ytmytm/C128-keyboard/kicad-c128keyb/DB25-pins.txt

GND	1	GND
NC	2	KEY
NMI	3	RESTORE
VCC	4	VCC

X0	13	PA0	COL
X1	19	PA1
X2	18	PA2
X3	17	PA3
X4	16	PA4
X5	15	PA5
X6	14	PA6
X7	20	PA7
X8	21	K0
X9	22	K1
X10	23	K2

Y0	12	PB0	ROW
Y1	11	PB1
Y2	10	PB2
Y3	5	PB3
Y4	8	PB4
Y5	7	PB5
Y6	6	PB6
Y7	9	PB7

CAPS	25	CAPS
40/80	24	40/80
