ytmytm/C128-keyboard/docs/OPL_Kicad_Library/OPL_List_2019-02-14.xlsx

Sheet: SZOPL
no. | Model | Category | Brand | Desc | Price | Encap
23 | CC0805KRX7R9BB104 | Capacitors | Yageo | 0805 100nF ±10% 50V X7R | 50~0.18|200~0.15|500~0.14|1000~0.13|2000~0.125|4000~0.12 | 805
24 | GRM188R71H104KA93D | Capacitors | Murata | 0603 100nF ±10% 50V X7R | 10~0.1751|200~0.1626|500~0.1563|1000~0.1501|2000~0.1438|4000~0.1376 | 0603（1608 metric）
30 | GCM188R71E105KA64D | Capacitors | Murata | 0603 1μF ±10% 25V X7R | 10~0.3065|100~0.2299|300~0.2158|1000~0.2017|5000~0.1955 | 0603（1608 metric）
31 | CC0603KRX7R7BB104 | Capacitors | Yageo | 0603 100nF ±10% 16V X7R | 50~0.0432|200~0.036|500~0.0336|1000~0.0312|2000~0.03|4000~0.0288 | 603
37 | TAJA226K010RNJ | Capacitors | AVX | A-type 22µF ±10% 10V ESR=3Ω@100kHz | 1~1.0486|10~0.7938|30~0.7448|100~0.7056|500~0.6762 | 1206（3216 metric）
38 | TAJB476K010RNJ | Capacitors | AVX | B-type 47µF ±10% 10V ESR=1Ω@100kHz | 5~0.7229|50~0.5481|150~0.516|500~0.4838|2500~0.4696 | 1411（3528 metric）
39 | TAJE107M025RNJ | Capacitors | AVX | E-type 100µF ±20% 25V ESR=0.3Ω@100kHz | 1~6.5464|10~4.9196|30~4.6256|100~4.3218|500~4.1944 | 2917（7343 metric）
41 | TAJA106K016RNJ | Capacitors | AVX | A-type 10µF ±10% 16V ESR=3Ω@100kHz | 1~0.9898|10~0.7448|30~0.7056|100~0.6566|500~0.637 | 1206（3216 metric）
92 | GRM188R60J106ME47J | Capacitors | Murata | 0603 10μF ±20% 6.3V X5R | 50~0.3684|200~0.2947|500~0.2671|1000~0.2579|2000~0.2487|4000~0.2395 | 0603（1608 metric）
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
3926 | CC0201CRNPO9BN1R2 | Capacitors | Yageo | 0201 1.2pF ±0.25PF 50V C0G | 50~0.0259|200~0.0216|500~0.0201|1000~0.0187|5000~0.018|10000~0.0173 | 201
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
