ytmytm/C128-keyboard/tests/README.md

# Keyboard event regression tests

Run from the repository root:

```sh
python3 tests/test_keyboard_events.py
python3 -m unittest discover -s tests -p 'test_firmware_artifacts.py' -v
```

Requires Python 3 and GCC's g++ with AddressSanitizer and
UndefinedBehaviorSanitizer. Compilation uses `-Wall -Wextra -Werror`;
warnings fail the build. The language standard is C++14, matching the
[Seeed SAMD compiler configuration](https://github.com/Seeed-Studio/ArduinoCore-samd/blob/master/platform.txt).
Compile-time assertions also verify key lookup and modifier table sizes.

The Python runner reads functions directly from the firmware and compiles them
with the C++ scenarios in `keyboard_events.cpp`. It uses the real controller
class declaration, parser constructor and Parse implementation, controller
callbacks, the HID device release path, key maps, matrix event handling, constructor, reset and key-action callbacks.
Hardware I/O, USB transport, OLED drawing and ASCII conversion are mocked.
The status renderer itself is compiled from the sketch.
Temporary build files are removed automatically, including on test failure.

The runner first verifies that the installable library ZIP matches the source
folder and that the sketch rejects missing or outdated event API markers.
After editing the USB library, refresh its ZIP before running tests:

```sh
python3 tools/package_usb_library.py
```

Tests cover:

- Firmware date below startup USB status messages, ordinary one-line messages,
  and skipping the renderer when no OLED is present.

- Public modifier event usages `0xe0..0xe7` versus modifier masks, including
  Right Shift, HID usage `0x20` (3) and HID usage `0x2c` (Space).
- All 262,144 pairs of modifier masks across four keymaps, checking the expected
  matrix state, physical Shift flags and RESTORE pin after each transition.
- Ctrl + either Shift in both press/release orders, simultaneous changes,
  independent Shifts, and typing while Shift remains held.
- Six occupied HID slots, slot reordering, key replacement, repeated reports,
  reserved bytes, unknown usages, every error usage in every key slot, and
  report lengths from zero to seven bytes.
- Differential Shift in symbolic mappings and synthesized Shift for cursor
  and function keys; overlapping differential keys and Shift Lock with physical Shift.
- Both joystick ports, all four single-key keypad diagonals in every keymap,
  equivalence to two cardinal keys, 224 overlapping-direction release cases,
  six keypad slots plus right Ctrl, mode changes, OLED labels, diagonals with
  FIRE and Shift, all cardinal directions, three FIRE inputs, shared
  FIRE releases, route/count lifetime, and entering/leaving modes while held.
- Saved releases after changing a mapping to another key, IGNORE or an action.
- Reset, keymap switching and wrapping, momentary RESTORE, toggled 40/80 and
  CAPS pins (including reset), shared RESTORE sources, valid GPIO pin numbers,
  duplicate presses and unmatched releases.
- RESTORE versus DEL isolation and exact Shift/key write ordering.
- Disconnect with held modifiers, normal keys, FIRE, RESTORE and Shift Lock;
  reconnect with the same keys held; repeated releases and interfaces without
  a parser. The real HIDBoot release callback path is used with mocked USB I/O.

The transition count is a count of exercised cases, not a source coverage
percentage. These tests do not build the full Arduino sketch or verify
transport timing or electrical behavior.

For a hardware check, install the modified bundled
`SEEED/C64_USB_Host_Library_SAMD` library and rebuild the sketch; rebuilding
with an older installed library will not include the parser fix. Check Shift +
left Ctrl (C= in positional mode) in both press/release orders, then right Ctrl
and keypad 5 held together in each joystick mode. Releasing either FIRE input
must leave FIRE active until the other is also released.

The old `C128-keyboard-issue-3-shift.patch` is an alternative workaround and
must not be applied on top of the modifier event fix.

# Firmware build and UF2 artifacts

`test_firmware_artifacts.py` checks the release-date/tag contract and the
application/UF2 validator. It rejects invalid vectors, wrong family IDs,
bootloader addresses, incorrect block numbers, missing or reordered blocks,
corrupt payloads and nonzero padding. It needs only Python 3.

The [firmware workflow](../.github/workflows/firmware.yml) also performs a full
Arduino build, converts the BIN with the pinned official Microsoft converter,
and validates every UF2 payload byte before uploading build or release assets.
This compile/format check complements the mocked event tests and hardware tests.
