ytmytm/C128-keyboard/kicad-c128keyb/plots/kicad-c128keyb.pdf

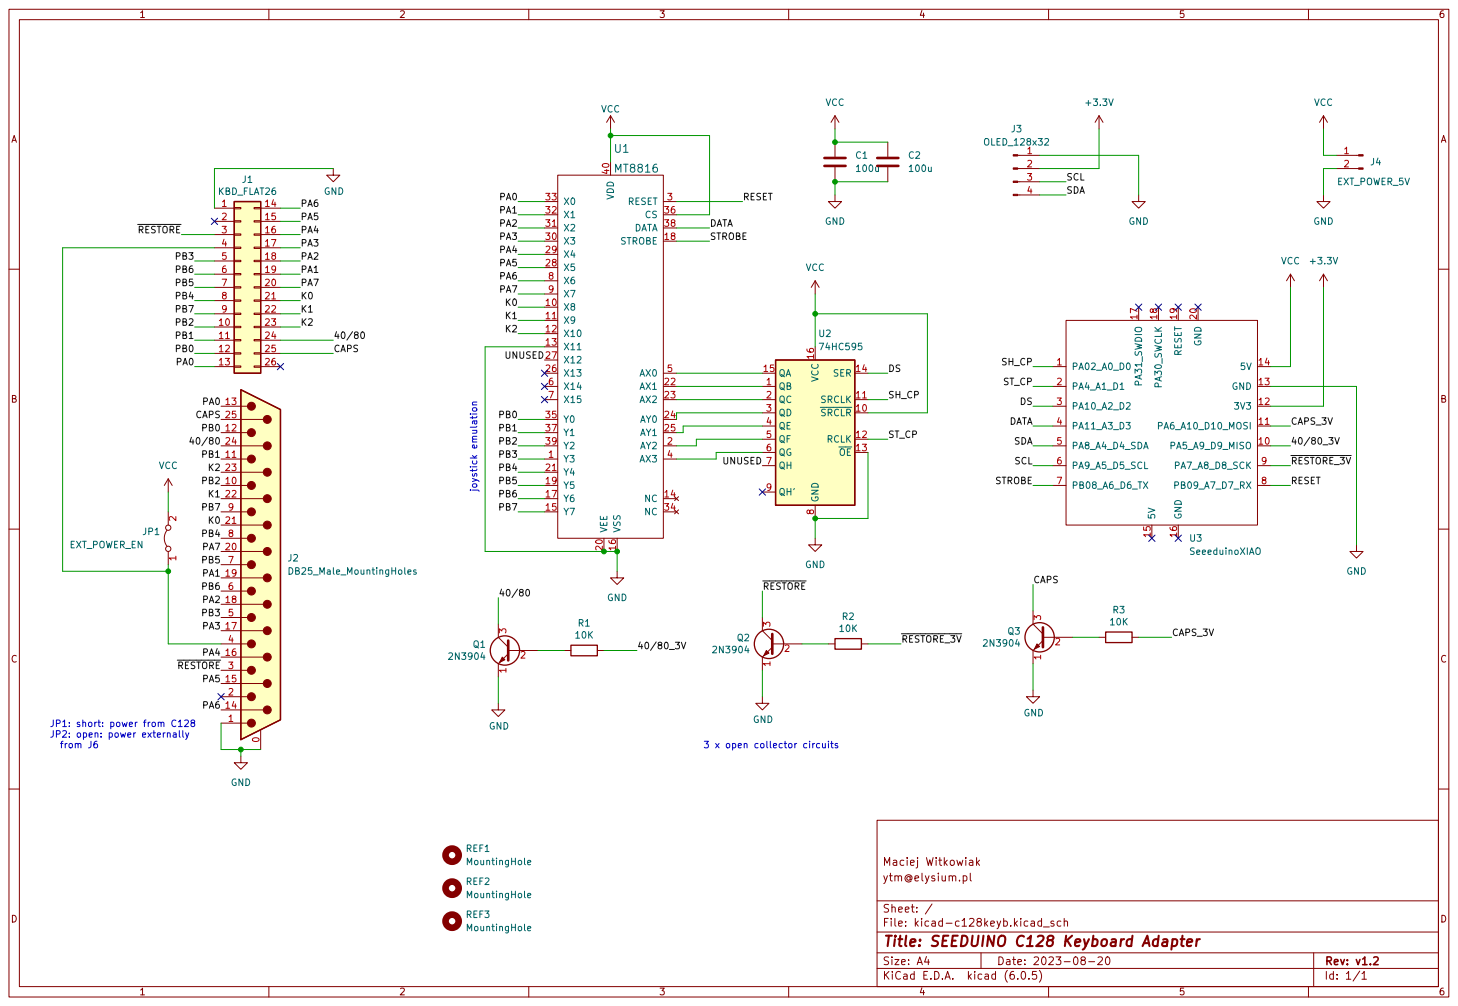
[picture p7: page 1]

Maciej Witkowiak
File: kicad-c128keyb.kicad_sch Sheet: / ytm@elysium.pl

Id: 1/1 Title: SEEDUINO C128 Keyboard Adapter
