ytmytm/C128-keyboard/(list of files, drawings)

Other design files:
kicad-c128keyb/kicad-c128keyb.dsn
