ytmytm/C128-keyboard/SEEED/C64_USB_Host_Library_SAMD/src/KeyboardController.h

/*
 Copyright (c) 2012 Arduino.  All right reserved.

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
 You should have received a copy of the GNU Lesser General Public
 License along with this library; if not, write to the Free Software
 Foundation, Inc., 51 Franklin St, Fifth Floor, Boston, MA  02110-1301  USA
 */

#ifndef KEYBOARD_CONTROLLER_H
#define KEYBOARD_CONTROLLER_H

#include <hidboot.h>

// The sketch depends on separate 0xe0..0xe7 modifier usages and disconnect callbacks.
#define C128_USB_HOST_EVENT_API_VERSION 1

enum KeyboardModifiers {
	LeftCtrl = 1,
	LeftShift = 2,
	Alt = 4,
	LeftCmd = 8,
	RightCtrl = 16,
	RightShift = 32,
	AltGr = 64,
	RightCmd = 128
};

class KeyboardController : public KeyboardReportParser {
public:
  KeyboardController(USBHost &usb) : hostKeyboard(&usb), key(0), keyOem(0), modifiers(0) {
    hostKeyboard.SetReportParser(0, this);
  };

  uint8_t getKey()       { return key; };
  uint8_t getModifiers() { return modifiers; };
  uint8_t getOemKey()    { return keyOem; };

protected:
  void OnDisconnect() override;
  void OnControlKeysChanged(uint8_t before, uint8_t after) override;
  void OnKeyDown(uint8_t mod, uint8_t key) override;
  void OnKeyUp(uint8_t mod, uint8_t key) override;

private:
  HIDBoot<HID_PROTOCOL_KEYBOARD> hostKeyboard;
  uint8_t key, keyOem, modifiers;
};

#endif
