ytmytm/C128-keyboard/SEEED/C128_keyboard/C128keyboard.c.ino

/*
  C128keyboard - Commodore Keyboard library

  Copyright (c) 2022 Hartland PC LLC
  Written by Robert VanHazinga

  Modified for C128 by Maciej 'YTM/Elysium' Witkowiak


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
*/

#include <map>

#include "C128keyboard.h"

// static keymap definitions, include only once
#include "keymaps.h"

#include <ShiftRegister74HC595.h>
ShiftRegister74HC595<1> sr(DS_PIN, SH_CP_PIN, ST_CP_PIN); // data, clock, latch

void resetMT88(void) {

  digitalWrite(NMI_PIN, LOW);
  digitalWrite(C128_40_80_PIN, LOW);
  digitalWrite(C128_CAPS_PIN, LOW);

  digitalWrite(ANALOG_SW_DATA , LOW);
  digitalWrite(ANALOG_SW_RESET, HIGH);
  digitalWrite(ANALOG_SW_STROBE, HIGH);
  delay(20);
  digitalWrite(ANALOG_SW_RESET, LOW);
  digitalWrite(ANALOG_SW_STROBE, LOW);
  digitalWrite(ANALOG_SW_DATA , HIGH);

  lshift = false;
  rshift = false;
  shiftlock = false;
  virtshift = false;

  keymapnum = 0;
  joymode = false;
  joynum = 2;
  joykeycount = 0;
  kpress = false;
  c128_4080 = false;
  c128_caps = false;
}


void setswitch(uint8_t c,bool kstate) {
  int bitr;
  bool state;
  uint8_t ax3;

  ax3 = 0;
  digitalWrite(ANALOG_SW_DATA , kstate);
  // Fix logic table hole in MT8812/16
  // Convert x12 & x13 to x6 & x7. AX3 line control
  if ((c > 55 && c < 64) || (c > 23 && c < 32 )) {
     c -= 24;
     ax3 = 1;
  }
  // C128 extra keys use only 3 rows, so we don't reach x12 & x13 anyway but ax3 must be active for x8/x9/x10
  if (c >= 64) {
    c -= 64;
    ax3 = 1;
  }
  if (c < 64) {
    for (uint8_t i = 0; i<(sizeof(ANALOG_SH_ARRAY)/sizeof(ANALOG_SH_ARRAY[0])); i++) {
      state =  bitRead(c, i);
      sr.setNoUpdate(ANALOG_SH_ARRAY[i], state);
    }
    sr.setNoUpdate(ANALOG_SH_AX3, ax3);
    sr.updateRegisters(); // update the pins to the set values
    digitalWrite( ANALOG_SW_STROBE, HIGH);
    digitalWrite( ANALOG_SW_STROBE, LOW);
  }

  // Reset switch state pin to default high state (Key press).
  //digitalWrite(ANALOG_SW_DATA , HIGH);
}

//////////////////////////////////////////////////////////////

const char* get_mapped_key_name(uint16_t keycode) {
    keycode &= ~MOD_SHIFT;
    for (const auto &info : key_infos) {
        if (info.get_keycode() == keycode) return info.get_name();
    }
    return nullptr;
}

//////////////////////////////////////////////////////////////

// This map will store the original keycode for each pressed key
std::map<uint8_t, uint16_t> keyStateTable;

constexpr uint8_t C128keyboard::getNumKeyMaps(void) { return nkeymaps; };

const char* C128keyboard::getCurrentKeyMapName(void) { return keymaps[keymapnum].getName(); };

uint16_t C128keyboard::mapkeycode(uint8_t kc) {

    if (joymode && (joynum == 1 || joynum == 2)) {
      struct JoystickKey {
        uint8_t usage;
        uint16_t port1;
        uint16_t port2;
      };
      static constexpr std::array<JoystickKey, 11> joystickKeys = {{
        {0x60, JOY1_UP,    JOY2_UP},    // keypad 8
        {0x5a, JOY1_DOWN,  JOY2_DOWN},  // keypad 2
        {0x5c, JOY1_LEFT,  JOY2_LEFT},  // keypad 4
        {0x5e, JOY1_RIGHT, JOY2_RIGHT}, // keypad 6
        {0x59, JOY1_LEFT  | MOD_JOY_DOWN, JOY2_LEFT  | MOD_JOY_DOWN}, // keypad 1
        {0x5b, JOY1_RIGHT | MOD_JOY_DOWN, JOY2_RIGHT | MOD_JOY_DOWN}, // keypad 3
        {0x5f, JOY1_LEFT  | MOD_JOY_UP,   JOY2_LEFT  | MOD_JOY_UP},   // keypad 7
        {0x61, JOY1_RIGHT | MOD_JOY_UP,   JOY2_RIGHT | MOD_JOY_UP},   // keypad 9
        {0x5d, JOY1_FIRE,  JOY2_FIRE},  // keypad 5
        {0x62, JOY1_FIRE,  JOY2_FIRE},  // keypad 0
        {0xe4, JOY1_FIRE,  JOY2_FIRE},  // right Ctrl
      }};
      for (const auto &key : joystickKeys) {
        if (key.usage == kc) {
          return joynum == 1 ? key.port1 : key.port2 | MOD_JOY2;
        }
      }
    }

    // Modifiers arrive as individual HID usages, just like normal keys.
    if (kc >= 0xe0 && kc <= 0xe7) {
      return keymaps[keymapnum].getMods()[kc - 0xe0];
    }

    // scan for any other key
    return keymaps[keymapnum].getKey(kc).get(lshift || rshift || shiftlock || virtshift);
}


// Shift Lock, physical modifiers and differential mappings share the same
// switches. Recompute them from all held keys rather than restoring them on
// the release of just one differential key.
void C128keyboard::updateShiftSwitches(void) {
    bool inverted = false;
    for (const auto &entry : keyStateTable) {
        if (entry.second & MOD_SHIFT) inverted = true;
    }
    const bool left = lshift || shiftlock || virtshift;
    setswitch(KEY_LSHIFT, inverted ? !(left || rshift) : left);
    setswitch(KEY_RSHIFT, inverted ? false : rshift);
}

void C128keyboard::c64key(uint16_t c, bool kpress, uint8_t kc) {

    // Resolve releases before any side effects: the active keymap or
    // joystick mode may have changed since this physical key was pressed.
    if (kpress) {
        if (c == IGNORE_KEYCODE || keyStateTable.count(kc)) return;
        keyStateTable[kc] = c;
    } else {
        auto it = keyStateTable.find(kc);
        if (it == keyStateTable.end()) return;
        c = it->second;
        keyStateTable.erase(it);
    }

    // Both AltGr and PageUp can hold RESTORE. Releasing either source must
    // leave NMI asserted until the final source is released.
    if (c == KEY_RESTORE) {
      bool held = false;
      for (const auto &entry : keyStateTable) {
        if (entry.second == KEY_RESTORE) held = true;
      }
      digitalWrite(NMI_PIN, held);
      return;
    }

    const auto switches = getMatrixSwitches(c);
    if (c == KEY_LSHIFT) lshift = kpress;
    if (c == KEY_RSHIFT) rshift = kpress;

    if (c & MOD_JOY2) {
      if (kpress) { joykeycount++; } else if (joykeycount) { joykeycount--; }
      setswitch(JOY2_ROUTE_GND, joykeycount != 0);
      c -= MOD_JOY2;
    }

    const bool updateShifts = c == KEY_LSHIFT || c == KEY_RSHIFT || (c & MOD_SHIFT);

    // Establish Shift before closing a key; release a key before restoring Shift.
    if (updateShifts && kpress) updateShiftSwitches();

    // Keep every component active while any saved mapping still needs it.
    for (const auto target : switches) {
      if (target >= 128 || target == KEY_LSHIFT || target == KEY_RSHIFT) continue;
      bool held = false;
      for (const auto &entry : keyStateTable) {
        const auto active = getMatrixSwitches(entry.second);
        if (active[0] == target || active[1] == target) held = true;
      }
      setswitch(target, kpress || held);
    }
    if (updateShifts && !kpress) updateShiftSwitches();
}


void C128keyboard::clearAllKeys(void) {
  keyStateTable.clear();
  digitalWrite(NMI_PIN, LOW);
  joykeycount = 0;
  lshift = false;
  rshift = false;
  shiftlock = false;
  virtshift = false;
  // MT88xx RESET substitute, just go through all the switches in the matrix and clear them
  for (uint8_t c=0;c<128;c++) { // we have 7 address bits only (AX0..3, AY0..2)
    setswitch(c,LOW);
  }
}


C128keyboard::C128keyboard() {

  // initialize the pins
  pinMode(ANALOG_SW_STROBE, OUTPUT);  // MT88XX strobe
  pinMode(ANALOG_SW_DATA, OUTPUT);   // MT88XX data
  pinMode(ANALOG_SW_RESET, OUTPUT); // MT88XX reset

  pinMode(NMI_PIN, OUTPUT);
  pinMode(C128_40_80_PIN, OUTPUT);
  pinMode(C128_CAPS_PIN, OUTPUT);

  resetMT88();

}
