ytmytm/C128-keyboard/SEEED/C128_keyboard/keymaps.h

//  C64/C128 key maps: symbolic and positional
//
//  Maciej 'YTM/Elysium' Witkowiak

// mapped key information
constexpr static C64KeyInfo key_infos[] = {
   { KEY_DEL, "INST/DEL" }
  ,{ KEY_F1, "F1" }
  ,{ KEY_HORZ_CSR, "CRSR <->" }
  ,{ KEY_F5, "F5" }
  ,{ KEY_RETURN, "RETURN" }
  ,{ KEY_F3, "F3" }
  ,{ KEY_F7, "F7" }
  ,{ KEY_VERT_CSR, "CRSR ^v" }
  ,{ KEY_9, "9" }
  ,{ KEY_M, "M" }
  ,{ KEY_J, "J" }
  ,{ KEY_O, "O" }
  ,{ KEY_I, "I" }
  ,{ KEY_K, "K" }
  ,{ KEY_ZERO, "0" }
  ,{ KEY_N, "N" }
  ,{ KEY_5, "5" }
  ,{ KEY_C, "C" }
  ,{ KEY_D, "D" }
  ,{ KEY_T, "T" }
  ,{ KEY_R, "R" }
  ,{ KEY_F, "F" }
  ,{ KEY_6, "6" }
  ,{ KEY_X, "X" }
  ,{ KEY_POUND, "POUND" }
  ,{ KEY_RSHIFT, "right SHIFT" }
  ,{ KEY_SEMICOLON, ";" }
  ,{ KEY_ARR_UP, "^" }
  ,{ KEY_STAR, "*" }
  ,{ KEY_EQUALS, "=" }
  ,{ KEY_HOME, "CLR/HOME" }
  ,{ KEY_SLASH, "/" }
  ,{ KEY_3, "3" }
  ,{ KEY_Z, "Z" }
  ,{ KEY_A, "A" }
  ,{ KEY_E, "E" }
  ,{ KEY_W, "W" }
  ,{ KEY_S, "S" }
  ,{ KEY_4, "4" }
  ,{ KEY_LSHIFT, "left SHIFT" }
  ,{ KEY_PLUS, "+" }
  ,{ KEY_DOT, "." }
  ,{ KEY_L, "L" }
  ,{ KEY_AT, "@" }
  ,{ KEY_P, "P" }
  ,{ KEY_COLON, ":" }
  ,{ KEY_MINUS, "-" }
  ,{ KEY_COMMA, "," }
  ,{ KEY_7, "7" }
  ,{ KEY_B, "B" }
  ,{ KEY_G, "G" }
  ,{ KEY_U, "U" }
  ,{ KEY_Y, "Y" }
  ,{ KEY_H, "H" }
  ,{ KEY_8, "8" }
  ,{ KEY_V, "V" }
  ,{ KEY_1, "1" }
  ,{ KEY_SPACE, "SPACE" }
  ,{ KEY_CTRL, "CTRL" }
  ,{ KEY_Q, "Q" }
  ,{ KEY_ARR_LEFT, "<-" }
  ,{ KEY_CBM, "C=" }
  ,{ KEY_2, "2" }
  ,{ KEY_RUN_STOP, "RUN/STOP" }
  ,{ C128_KEY_HELP, "HELP" }
  ,{ C128_KEYPAD_2, "keypad 2" }
  ,{ C128_KEYPAD_5, "keypad 5" }
  ,{ C128_KEYPAD_7, "keypad 7" }
  ,{ C128_KEYPAD_8, "keypad 8" }
  ,{ C128_KEYPAD_4, "keypad 4" }
  ,{ C128_KEY_TAB, "TAB" }
  ,{ C128_KEYPAD_1, "keypad 1" }
  ,{ C128_KEY_ESC, "ESC" }
  ,{ C128_KEYPAD_ENTER, "keypad ENTER" }
  ,{ C128_KEYPAD_MINUS, "keypad -" }
  ,{ C128_KEYPAD_9, "keypad 9" }
  ,{ C128_KEYPAD_PLUS, "keypad +" }
  ,{ C128_KEYPAD_6, "keypad 6" }
  ,{ C128_KEY_LINEFEED, "LINE FEED" }
  ,{ C128_KEYPAD_3, "keypad 3" }
  ,{ C128_KEY_ALT, "ALT" }
  ,{ C128_KEY_DOWN, "cursor v" }
  ,{ C128_KEYPAD_DOT, "keypad DOT" }
  ,{ C128_KEY_RIGHT, "cursor ->" }
  ,{ C128_KEYPAD_0, "keypad 0" }
  ,{ C128_KEY_LEFT, "cursor <-" }
  ,{ C128_KEY_UP, "cursor ^" }
  ,{ C128_KEY_NOSCROLL, "NO SCROLL" }
  ,{ JOY1_UP, "joy#1 UP" }
  ,{ JOY1_DOWN, "joy#1 DOWN" }
  ,{ JOY1_LEFT, "joy#1 LEFT" }
  ,{ JOY1_RIGHT, "joy#1 RIGHT" }
  ,{ JOY1_FIRE, "joy#1 FIRE" }
  ,{ JOY1_LEFT  | MOD_JOY_DOWN, "joy#1 DOWN LEFT" }
  ,{ JOY1_RIGHT | MOD_JOY_DOWN, "joy#1 DOWN RIGHT" }
  ,{ JOY1_LEFT  | MOD_JOY_UP, "joy#1 UP LEFT" }
  ,{ JOY1_RIGHT | MOD_JOY_UP, "joy#1 UP RIGHT" }
  /*
  ,{ JOY2_UP, "joy#2 UP" }
  ,{ JOY2_DOWN, "joy#2 DOWN" }
  ,{ JOY2_LEFT, "joy#2 LEFT" }
  ,{ JOY2_RIGHT, "joy#2 RIGHT" }
  ,{ JOY2_FIRE, "joy#2 FIRE" }
  */
  ,{ JOY2_UP | MOD_JOY2, "joy#2 UP" }
  ,{ JOY2_DOWN | MOD_JOY2, "joy#2 DOWN" }
  ,{ JOY2_LEFT | MOD_JOY2, "joy#2 LEFT" }
  ,{ JOY2_RIGHT | MOD_JOY2, "joy#2 RIGHT" }
  ,{ JOY2_FIRE | MOD_JOY2, "joy#2 FIRE" }
  ,{ JOY2_LEFT  | MOD_JOY_DOWN | MOD_JOY2, "joy#2 DOWN LEFT" }
  ,{ JOY2_RIGHT | MOD_JOY_DOWN | MOD_JOY2, "joy#2 DOWN RIGHT" }
  ,{ JOY2_LEFT  | MOD_JOY_UP | MOD_JOY2, "joy#2 UP LEFT" }
  ,{ JOY2_RIGHT | MOD_JOY_UP | MOD_JOY2, "joy#2 UP RIGHT" }
  ,{ MOD_SHIFT, "virtual SHIFT" }
  ,{ KEY_RESTORE, "RESTORE" }
  ,{ KEY_KEYMAP, "switch keymap" }
  ,{ KEY_MT_RESET, "reset MT88XX" }
  ,{ KEY_SHIFT_LOCK, "SHIFT LOCK" }
  ,{ C128_40_80_KEY, "40/80" }
  ,{ C128_CAPS_KEY, "CAPS/DIN" }
  ,{ KEY_JOY1_MODE, "toggle joy#1" }
  ,{ KEY_JOY2_MODE, "toggle joy#2" }
  ,{ IGNORE_KEYCODE, "ignore key" }
};


////////////////////////////////////////////////////////////////////////////////////////////////////////////////////////////////////

//static const uint16_t MODKEYS[8] {KEY_CTRL,KEY_LSHIFT,KEY_RUN_STOP,KEY_CBM,KEY_CTRL,KEY_RSHIFT,KEY_RUN_STOP,0};
// MODKEYS bits
// 0 - 0x01 - left CTRL
// 1 - 0x02 - left SHIFT
// 2 - 0x04 - left ALT
// 3 - 0x08 - left Windows
// 4 - 0x10 - right CTRL
// 5 - 0x20 - right SHIFT(?)
// 6 - 0x40 - right ALT (AltGr)
// 7 - 0x80 - right Windows

////////////////////////////////////////////////////////////////////////////////////////////////////////////////////////////////////

// positional
// c128 positional (top row cursors moved to win/alt (space) menu/ctrl; left control is cbm, shifts unchanged, altgr is RESTORE)
constexpr static ModifierMap C128_pos_mods = {{KEY_CBM,KEY_LSHIFT,C128_KEY_DOWN,C128_KEY_UP,C128_KEY_RIGHT,KEY_RSHIFT,KEY_RESTORE,IGNORE_KEYCODE}};
constexpr static C64Key C128_pos_keys[] = {
   { 0x00, IGNORE_KEYCODE, IGNORE_KEYCODE }  // Reserved
  ,{ 0x01, IGNORE_KEYCODE, IGNORE_KEYCODE }  // ErrorRollOver
  ,{ 0x02, IGNORE_KEYCODE, IGNORE_KEYCODE }  // POSTFail
  ,{ 0x03, IGNORE_KEYCODE, IGNORE_KEYCODE }  // ErrorUndefined
  ,{ 0x04, KEY_A,          KEY_A }  // a and A
  ,{ 0x05, KEY_B,          KEY_B }
  ,{ 0x06, KEY_C,          KEY_C }
  ,{ 0x07, KEY_D,          KEY_D }
  ,{ 0x08, KEY_E,          KEY_E }
  ,{ 0x09, KEY_F,          KEY_F }
  ,{ 0x0a, KEY_G,          KEY_G }
  ,{ 0x0b, KEY_H,          KEY_H }
  ,{ 0x0c, KEY_I,          KEY_I }
  ,{ 0x0d, KEY_J,          KEY_J }
  ,{ 0x0e, KEY_K,          KEY_K }
  ,{ 0x0f, KEY_L,          KEY_L }
  ,{ 0x10, KEY_M,          KEY_M }
  ,{ 0x11, KEY_N,          KEY_N }
  ,{ 0x12, KEY_O,          KEY_O }
  ,{ 0x13, KEY_P,          KEY_P }
  ,{ 0x14, KEY_Q,          KEY_Q }
  ,{ 0x15, KEY_R,          KEY_R }
  ,{ 0x16, KEY_S,          KEY_S }
  ,{ 0x17, KEY_T,          KEY_T }
  ,{ 0x18, KEY_U,          KEY_U }
  ,{ 0x19, KEY_V,          KEY_V }
  ,{ 0x1a, KEY_W,          KEY_W }
  ,{ 0x1b, KEY_X,          KEY_X }
  ,{ 0x1c, KEY_Y,          KEY_Y }
  ,{ 0x1d, KEY_Z,          KEY_Z }  // z and Z
  ,{ 0x1e, KEY_1,          KEY_1 }  // 1 and !
  ,{ 0x1f, KEY_2,          KEY_2 }  // 2 and @
  ,{ 0x20, KEY_3,          KEY_3 }  // 3 and #
  ,{ 0x21, KEY_4,          KEY_4 }  // 4 and $
  ,{ 0x22, KEY_5,          KEY_5 }  // 5 and %
  ,{ 0x23, KEY_6,          KEY_6 }  // 6 and ^
  ,{ 0x24, KEY_7,          KEY_7 }  // 7 and &
  ,{ 0x25, KEY_8,          KEY_8 }  // 8 and *
  ,{ 0x26, KEY_9,          KEY_9 }  // 9 and (
  ,{ 0x27, KEY_ZERO,       KEY_ZERO }         // 0 and )
  ,{ 0x28, KEY_RETURN,     KEY_RETURN }       // Return
  ,{ 0x29, KEY_RUN_STOP,   KEY_RUN_STOP }     // Escape
  ,{ 0x2a, KEY_DEL,        KEY_DEL }          // Delete (Backspace)
  ,{ 0x2b, KEY_CTRL,       KEY_CTRL }         // Tab
  ,{ 0x2c, KEY_SPACE,      KEY_SPACE }        // Spacebar
  ,{ 0x2d, KEY_PLUS,       KEY_PLUS }         // - and _
  ,{ 0x2e, KEY_MINUS,      KEY_MINUS }        // = and +
  ,{ 0x2f, KEY_AT,         KEY_AT }           // [ and {
  ,{ 0x30, KEY_STAR,       KEY_STAR }         // ] and }
  ,{ 0x31, KEY_EQUALS,     KEY_EQUALS }       // \ and |
  ,{ 0x32, IGNORE_KEYCODE, IGNORE_KEYCODE }   // Int' # and ~
  ,{ 0x33, KEY_COLON,      KEY_COLON }        // ; and :
  ,{ 0x34, KEY_SEMICOLON,  KEY_SEMICOLON }    // ‘ and “
  ,{ 0x35, KEY_ARR_LEFT,   KEY_ARR_LEFT }     // Grave Accent and Tilde
  ,{ 0x36, KEY_COMMA,      KEY_COMMA }        // , and <
  ,{ 0x37, KEY_DOT,        KEY_DOT }          // . and >
  ,{ 0x38, KEY_SLASH,      KEY_SLASH }        // / and ?
  ,{ 0x39, KEY_RUN_STOP,   KEY_RUN_STOP }     // Caps Lock
  ,{ 0x3a, C128_KEY_ESC,   C128_KEY_ESC }     // F1
  ,{ 0x3b, C128_KEY_TAB,   C128_KEY_TAB }     // F2
  ,{ 0x3c, C128_KEY_ALT,   C128_KEY_ALT }     // F3
  ,{ 0x3d, C128_CAPS_KEY,  C128_CAPS_KEY }    // F4
  ,{ 0x3e, C128_KEY_HELP,  C128_KEY_HELP }    // F5
  ,{ 0x3f, C128_KEY_LINEFEED, C128_KEY_LINEFEED } // F6
  ,{ 0x40, C128_40_80_KEY, C128_40_80_KEY }   // F7
  ,{ 0x41, C128_KEY_NOSCROLL, C128_KEY_NOSCROLL } // F8
  ,{ 0x42, KEY_F1,         KEY_F1 }           // F9
  ,{ 0x43, KEY_F3,         KEY_F3 }           // F10
  ,{ 0x44, KEY_F5,         KEY_F5 }           // F11
  ,{ 0x45, KEY_F7,         KEY_F7 }           // F12
  ,{ 0x46, KEY_MT_RESET,   KEY_MT_RESET }     // PrintScreen
  ,{ 0x47, KEY_SHIFT_LOCK, KEY_SHIFT_LOCK }   // Scroll Lock
  ,{ 0x48, KEY_KEYMAP,     KEY_KEYMAP }       // Pause
  ,{ 0x49, KEY_POUND,      KEY_POUND }        // Insert
  ,{ 0x4a, KEY_HOME,       KEY_HOME }         // Home
  ,{ 0x4b, KEY_RESTORE,    KEY_RESTORE }      // PageUp
  ,{ 0x4c, KEY_ARR_UP,     KEY_ARR_UP }       // Delete(forward)
  ,{ 0x4d, KEY_RUN_STOP,   KEY_RUN_STOP }     // End
  ,{ 0x4e, IGNORE_KEYCODE, IGNORE_KEYCODE }   // PageDown
  ,{ 0x4f, KEY_HORZ_CSR,   KEY_HORZ_CSR }     // RightArrow
  ,{ 0x50, KEY_HORZ_CSR | MOD_SHIFT, KEY_HORZ_CSR }     // LeftArrow
  ,{ 0x51, KEY_VERT_CSR,   KEY_VERT_CSR }     // DownArrow
  ,{ 0x52, KEY_VERT_CSR | MOD_SHIFT, KEY_VERT_CSR } // UpArrow
  ,{ 0x53, KEY_JOY2_MODE,  KEY_JOY1_MODE }    // Keypad Num Lock and Clear
  ,{ 0x54, KEY_SLASH,      KEY_SLASH }        // Keypad /
  ,{ 0x55, KEY_STAR,       KEY_STAR }         // Keypad *
  ,{ 0x56, C128_KEYPAD_MINUS, C128_KEYPAD_MINUS }   // Keypad -
  ,{ 0x57, C128_KEYPAD_PLUS, C128_KEYPAD_PLUS }     // Keypad +
  ,{ 0x58, C128_KEYPAD_ENTER, C128_KEYPAD_ENTER }   // Keypad ENTER
  ,{ 0x59, C128_KEYPAD_1,  C128_KEYPAD_1 }    // Keypad 1 and End
  ,{ 0x5a, C128_KEYPAD_2,  C128_KEYPAD_2 }    // Keypad 2 and Down Arrow
  ,{ 0x5b, C128_KEYPAD_3,  C128_KEYPAD_3 }    // Keypad 3 and PageDn
  ,{ 0x5c, C128_KEYPAD_4,  C128_KEYPAD_4 }    // Keypad 4 and Left Arrow
  ,{ 0x5d, C128_KEYPAD_5,  C128_KEYPAD_5 }    // Keypad 5
  ,{ 0x5e, C128_KEYPAD_6,  C128_KEYPAD_6 }    // Keypad 6 and Right Arrow
  ,{ 0x5f, C128_KEYPAD_7,  C128_KEYPAD_7 }    // Keypad 7 and Home
  ,{ 0x60, C128_KEYPAD_8,  C128_KEYPAD_8 }    // Keypad 8 and Up Arrow
  ,{ 0x61, C128_KEYPAD_9,  C128_KEYPAD_9 }    // Keypad 9 and PageUp
  ,{ 0x62, C128_KEYPAD_0,  C128_KEYPAD_0 }    // Keypad 0 and Insert
  ,{ 0x63, C128_KEYPAD_DOT, C128_KEYPAD_DOT } // Keypad . and Delete
  ,{ 0x64, KEY_EQUALS,     KEY_EQUALS }       // \ and | (non-US keyboard)
  ,{ 0x65, C128_KEY_LEFT,  C128_KEY_LEFT }    // Application (Menu)

  // symbolic mapping of extra keys that possibly exist on some keyboards
  ,{ 0x75, C128_KEY_HELP,  C128_KEY_HELP }    // Help

  ,{ 0xb6, KEY_8 | MOD_SHIFT, KEY_8 }         // Keypad (
  ,{ 0xb7, KEY_9 | MOD_SHIFT, KEY_9 }         // Keypad )

  ,{ 0xba, C128_KEY_TAB,   C128_KEY_TAB }     // Keypad Tab
  ,{ 0xbb, KEY_DEL,        KEY_DEL }          // Keypad Backspace
  ,{ 0xbc, KEY_A,          KEY_A }            // Keypad A
  ,{ 0xbd, KEY_B,          KEY_B }            // Keypad B
  ,{ 0xbe, KEY_C,          KEY_C }            // Keypad C
  ,{ 0xbf, KEY_D,          KEY_D }            // Keypad D
  ,{ 0xc0, KEY_E,          KEY_E }            // Keypad E
  ,{ 0xc1, KEY_F,          KEY_F }            // Keypad F

  ,{ 0xc3, KEY_ARR_UP,     KEY_ARR_UP }       // Keypad ^
  ,{ 0xc4, KEY_5 | MOD_SHIFT, KEY_5 }         // Keypad %
  ,{ 0xc5, KEY_COMMA | MOD_SHIFT, KEY_COMMA } // Keypad <
  ,{ 0xc6, KEY_DOT | MOD_SHIFT, KEY_DOT }     // Keypad >
  ,{ 0xc7, KEY_6 | MOD_SHIFT, KEY_6 }         // Keypad &

  ,{ 0xc9, KEY_POUND,      KEY_POUND }        // Keypad |

  ,{ 0xcb, KEY_COLON,      KEY_COLON }        // Keypad :
  ,{ 0xcc, KEY_3 | MOD_SHIFT, KEY_3 }         // Keypad #
  ,{ 0xcd, KEY_SPACE,      KEY_SPACE }        // Keypad Space
  ,{ 0xce, KEY_AT,         KEY_AT }           // Keypad @
  ,{ 0xcf, KEY_1 | MOD_SHIFT, KEY_1 }         // Keypad !

  ,{ 0xd7, KEY_PLUS,      KEY_MINUS }         // Keypad +/-

};

constexpr static uint16_t C128_pos_nkeys = sizeof(C128_pos_keys) / sizeof(C128_pos_keys[0]);

////////////////////////////////////////////////////////////////////////////////////////////////////////////////////////////////////

// symbolic
// C128 top row cursors assigned to shift+cursor arrows
// c128 symbolic (both controls are CTRL, both shifts unchanged, left/right WIN is CBM, left ALT is C128 ALT, altgr is RESTORE)
constexpr static ModifierMap C128_sym_mods = {{KEY_CTRL, KEY_LSHIFT, C128_KEY_ALT, KEY_CBM, KEY_CTRL, KEY_RSHIFT, KEY_RESTORE, KEY_CBM}};
constexpr static C64Key C128_sym_keys[] = {
   { 0x00, IGNORE_KEYCODE, IGNORE_KEYCODE }  // Reserved
  ,{ 0x01, IGNORE_KEYCODE, IGNORE_KEYCODE }  // ErrorRollOver
  ,{ 0x02, IGNORE_KEYCODE, IGNORE_KEYCODE }  // POSTFail
  ,{ 0x03, IGNORE_KEYCODE, IGNORE_KEYCODE }  // ErrorUndefined
  ,{ 0x04, KEY_A,          KEY_A }  // a and A
  ,{ 0x05, KEY_B,          KEY_B }
  ,{ 0x06, KEY_C,          KEY_C }
  ,{ 0x07, KEY_D,          KEY_D }
  ,{ 0x08, KEY_E,          KEY_E }
  ,{ 0x09, KEY_F,          KEY_F }
  ,{ 0x0a, KEY_G,          KEY_G }
  ,{ 0x0b, KEY_H,          KEY_H }
  ,{ 0x0c, KEY_I,          KEY_I }
  ,{ 0x0d, KEY_J,          KEY_J }
  ,{ 0x0e, KEY_K,          KEY_K }
  ,{ 0x0f, KEY_L,          KEY_L }
  ,{ 0x10, KEY_M,          KEY_M }
  ,{ 0x11, KEY_N,          KEY_N }
  ,{ 0x12, KEY_O,          KEY_O }
  ,{ 0x13, KEY_P,          KEY_P }
  ,{ 0x14, KEY_Q,          KEY_Q }
  ,{ 0x15, KEY_R,          KEY_R }
  ,{ 0x16, KEY_S,          KEY_S }
  ,{ 0x17, KEY_T,          KEY_T }
  ,{ 0x18, KEY_U,          KEY_U }
  ,{ 0x19, KEY_V,          KEY_V }
  ,{ 0x1a, KEY_W,          KEY_W }
  ,{ 0x1b, KEY_X,          KEY_X }
  ,{ 0x1c, KEY_Y,          KEY_Y }
  ,{ 0x1d, KEY_Z,          KEY_Z }  // z and Z
  ,{ 0x1e, KEY_1,          KEY_1 }  // 1 and !
  ,{ 0x1f, KEY_2,          KEY_AT | MOD_SHIFT } // 2 and @
  ,{ 0x20, KEY_3,          KEY_3 }  // 3 and #
  ,{ 0x21, KEY_4,          KEY_4 }  // 4 and $
  ,{ 0x22, KEY_5,          KEY_5 }  // 5 and %
  ,{ 0x23, KEY_6,          KEY_ARR_UP | MOD_SHIFT } // 6 and ^
  ,{ 0x24, KEY_7,          KEY_6 }  // 7 and &
  ,{ 0x25, KEY_8,          KEY_STAR | MOD_SHIFT } // 8 and *
  ,{ 0x26, KEY_9,          KEY_8 }  // 9 and (
  ,{ 0x27, KEY_ZERO,       KEY_9 }  // 0 and )
  ,{ 0x28, KEY_RETURN,     C128_KEY_LINEFEED | MOD_SHIFT } // Return
  ,{ 0x29, C128_KEY_ESC,   C128_KEY_ESC }     // Escape
  ,{ 0x2a, KEY_DEL,        KEY_DEL }          // Delete (Backspace)
  ,{ 0x2b, C128_KEY_TAB,   C128_KEY_TAB }     // Tab
  ,{ 0x2c, KEY_SPACE,      KEY_SPACE }        // Spacebar
  ,{ 0x2d, KEY_MINUS,      KEY_MINUS }        // - and _
  ,{ 0x2e, KEY_EQUALS,     KEY_PLUS | MOD_SHIFT } // = and +
  ,{ 0x2f, KEY_COLON | MOD_SHIFT, KEY_COLON } // [ and {
  ,{ 0x30, KEY_SEMICOLON | MOD_SHIFT, KEY_SEMICOLON } // ] and }
  ,{ 0x31, KEY_POUND,      KEY_POUND }        // \ and |
  ,{ 0x32, IGNORE_KEYCODE, IGNORE_KEYCODE }   // Int' # and ~
  ,{ 0x33, KEY_SEMICOLON,  KEY_COLON | MOD_SHIFT } // ; and :
  ,{ 0x34, KEY_7 | MOD_SHIFT,  KEY_2 }        // ‘ and “
  ,{ 0x35, KEY_ARR_LEFT,   KEY_ARR_LEFT }     // Grave Accent and Tilde
  ,{ 0x36, KEY_COMMA,      KEY_COMMA }        // , and <
  ,{ 0x37, KEY_DOT,        KEY_DOT }          // . and >
  ,{ 0x38, KEY_SLASH,      KEY_SLASH }        // / and ?
  ,{ 0x39, KEY_RUN_STOP,   KEY_RUN_STOP }     // Caps Lock
  ,{ 0x3a, KEY_F1,         KEY_F1 }           // F1
  ,{ 0x3b, KEY_F1 | MOD_SHIFT, KEY_F1 }       // F2
  ,{ 0x3c, KEY_F3,         KEY_F3 }           // F3
  ,{ 0x3d, KEY_F3 | MOD_SHIFT,  KEY_F3 }      // F4
  ,{ 0x3e, KEY_F5,         KEY_F5 }           // F5
  ,{ 0x3f, KEY_F5 | MOD_SHIFT, KEY_F5 }       // F6
  ,{ 0x40, KEY_F7,         KEY_F7 }           // F7
  ,{ 0x41, KEY_F7 | MOD_SHIFT, KEY_F7 }       // F8
  ,{ 0x42, C128_KEY_HELP,  C128_KEY_HELP }    // F9
  ,{ 0x43, C128_KEY_NOSCROLL, C128_KEY_NOSCROLL } // F10
  ,{ 0x44, C128_40_80_KEY, C128_40_80_KEY }   // F11
  ,{ 0x45, C128_CAPS_KEY,  C128_CAPS_KEY }    // F12
  ,{ 0x46, KEY_MT_RESET,   KEY_MT_RESET }     // PrintScreen
  ,{ 0x47, KEY_SHIFT_LOCK, KEY_SHIFT_LOCK }   // Scroll Lock
  ,{ 0x48, KEY_KEYMAP,     KEY_KEYMAP }       // Pause
  ,{ 0x49, KEY_DEL | MOD_SHIFT, KEY_DEL }     // Insert
  ,{ 0x4a, KEY_HOME,       KEY_HOME }         // Home
  ,{ 0x4b, KEY_RESTORE,    KEY_RESTORE }      // PageUp
  ,{ 0x4c, KEY_DEL,        KEY_DEL }          // Delete(forward)
  ,{ 0x4d, KEY_RUN_STOP,   KEY_RUN_STOP }     // End
  ,{ 0x4e, IGNORE_KEYCODE, IGNORE_KEYCODE }   // PageDown
  ,{ 0x4f, KEY_HORZ_CSR,   C128_KEY_RIGHT | MOD_SHIFT } // RightArrow
  ,{ 0x50, KEY_HORZ_CSR | MOD_SHIFT, C128_KEY_LEFT | MOD_SHIFT } // LeftArrow
  ,{ 0x51, KEY_VERT_CSR,   C128_KEY_DOWN | MOD_SHIFT } // DownArrow
  ,{ 0x52, KEY_VERT_CSR | MOD_SHIFT, C128_KEY_UP | MOD_SHIFT } // UpArrow
  ,{ 0x53, KEY_JOY2_MODE,  KEY_JOY1_MODE }    // Keypad Num Lock and Clear
  ,{ 0x54, KEY_SLASH,      KEY_SLASH }        // Keypad /
  ,{ 0x55, KEY_STAR,       KEY_STAR }         // Keypad *
  ,{ 0x56, C128_KEYPAD_MINUS, C128_KEYPAD_MINUS }   // Keypad -
  ,{ 0x57, C128_KEYPAD_PLUS, C128_KEYPAD_PLUS }     // Keypad +
  ,{ 0x58, C128_KEYPAD_ENTER, C128_KEYPAD_ENTER }   // Keypad ENTER
  ,{ 0x59, C128_KEYPAD_1,  C128_KEYPAD_1 }    // Keypad 1 and End
  ,{ 0x5a, C128_KEYPAD_2,  C128_KEYPAD_2 }    // Keypad 2 and Down Arrow
  ,{ 0x5b, C128_KEYPAD_3,  C128_KEYPAD_3 }    // Keypad 3 and PageDn
  ,{ 0x5c, C128_KEYPAD_4,  C128_KEYPAD_4 }    // Keypad 4 and Left Arrow
  ,{ 0x5d, C128_KEYPAD_5,  C128_KEYPAD_5 }    // Keypad 5
  ,{ 0x5e, C128_KEYPAD_6,  C128_KEYPAD_6 }    // Keypad 6 and Right Arrow
  ,{ 0x5f, C128_KEYPAD_7,  C128_KEYPAD_7 }    // Keypad 7 and Home
  ,{ 0x60, C128_KEYPAD_8,  C128_KEYPAD_8 }    // Keypad 8 and Up Arrow
  ,{ 0x61, C128_KEYPAD_9,  C128_KEYPAD_9 }    // Keypad 9 and PageUp
  ,{ 0x62, C128_KEYPAD_0,  C128_KEYPAD_0 }    // Keypad 0 and Insert
  ,{ 0x63, C128_KEYPAD_DOT, C128_KEYPAD_DOT } // Keypad . and Delete
  ,{ 0x64, KEY_POUND,      KEY_POUND }        // \ and | (non-US keyboard)
  ,{ 0x65, C128_KEY_LEFT,  C128_KEY_LEFT }    // Application (Menu)

  // symbolic mapping of extra keys that possibly exist on some keyboards
  ,{ 0x75, C128_KEY_HELP,  C128_KEY_HELP }    // Help

  ,{ 0xb6, KEY_8 | MOD_SHIFT, KEY_8 }         // Keypad (
  ,{ 0xb7, KEY_9 | MOD_SHIFT, KEY_9 }         // Keypad )

  ,{ 0xba, C128_KEY_TAB,   C128_KEY_TAB }     // Keypad Tab
  ,{ 0xbb, KEY_DEL,        KEY_DEL }          // Keypad Backspace
  ,{ 0xbc, KEY_A,          KEY_A }            // Keypad A
  ,{ 0xbd, KEY_B,          KEY_B }            // Keypad B
  ,{ 0xbe, KEY_C,          KEY_C }            // Keypad C
  ,{ 0xbf, KEY_D,          KEY_D }            // Keypad D
  ,{ 0xc0, KEY_E,          KEY_E }            // Keypad E
  ,{ 0xc1, KEY_F,          KEY_F }            // Keypad F

  ,{ 0xc3, KEY_ARR_UP,     KEY_ARR_UP }       // Keypad ^
  ,{ 0xc4, KEY_5 | MOD_SHIFT, KEY_5 }         // Keypad %
  ,{ 0xc5, KEY_COMMA | MOD_SHIFT, KEY_COMMA } // Keypad <
  ,{ 0xc6, KEY_DOT | MOD_SHIFT, KEY_DOT }     // Keypad >
  ,{ 0xc7, KEY_6 | MOD_SHIFT, KEY_6 }         // Keypad &

  ,{ 0xc9, KEY_POUND,      KEY_POUND }        // Keypad |

  ,{ 0xcb, KEY_COLON,      KEY_COLON }        // Keypad :
  ,{ 0xcc, KEY_3 | MOD_SHIFT, KEY_3 }         // Keypad #
  ,{ 0xcd, KEY_SPACE,      KEY_SPACE }        // Keypad Space
  ,{ 0xce, KEY_AT,         KEY_AT }           // Keypad @
  ,{ 0xcf, KEY_1 | MOD_SHIFT, KEY_1 }         // Keypad !

  ,{ 0xd7, KEY_PLUS,      KEY_MINUS }         // Keypad +/-

};

constexpr static uint16_t C128_sym_nkeys = sizeof(C128_sym_keys) / sizeof(C128_sym_keys[0]);

////////////////////////////////////////////////////////////////////////////////////////////////////////////////////////////////////

// positional
// c64 positional (top row cursors moved to win/alt (space) menu/ctrl; left control is cbm, shifts unchanged, altgr is RESTORE)
// the only difference to c128 positional is in numpad mapping - it goes to plain digit keys and RETURN
constexpr static ModifierMap C64_pos_mods = {{KEY_CBM,KEY_LSHIFT,C128_KEY_DOWN,C128_KEY_UP,C128_KEY_RIGHT,KEY_RSHIFT,KEY_RESTORE,IGNORE_KEYCODE}};
constexpr static C64Key C64_pos_keys[] = {
   { 0x00, IGNORE_KEYCODE, IGNORE_KEYCODE }  // Reserved
  ,{ 0x01, IGNORE_KEYCODE, IGNORE_KEYCODE }  // ErrorRollOver
  ,{ 0x02, IGNORE_KEYCODE, IGNORE_KEYCODE }  // POSTFail
  ,{ 0x03, IGNORE_KEYCODE, IGNORE_KEYCODE }  // ErrorUndefined
  ,{ 0x04, KEY_A,          KEY_A }  // a and A
  ,{ 0x05, KEY_B,          KEY_B }
  ,{ 0x06, KEY_C,          KEY_C }
  ,{ 0x07, KEY_D,          KEY_D }
  ,{ 0x08, KEY_E,          KEY_E }
  ,{ 0x09, KEY_F,          KEY_F }
  ,{ 0x0a, KEY_G,          KEY_G }
  ,{ 0x0b, KEY_H,          KEY_H }
  ,{ 0x0c, KEY_I,          KEY_I }
  ,{ 0x0d, KEY_J,          KEY_J }
  ,{ 0x0e, KEY_K,          KEY_K }
  ,{ 0x0f, KEY_L,          KEY_L }
  ,{ 0x10, KEY_M,          KEY_M }
  ,{ 0x11, KEY_N,          KEY_N }
  ,{ 0x12, KEY_O,          KEY_O }
  ,{ 0x13, KEY_P,          KEY_P }
  ,{ 0x14, KEY_Q,          KEY_Q }
  ,{ 0x15, KEY_R,          KEY_R }
  ,{ 0x16, KEY_S,          KEY_S }
  ,{ 0x17, KEY_T,          KEY_T }
  ,{ 0x18, KEY_U,          KEY_U }
  ,{ 0x19, KEY_V,          KEY_V }
  ,{ 0x1a, KEY_W,          KEY_W }
  ,{ 0x1b, KEY_X,          KEY_X }
  ,{ 0x1c, KEY_Y,          KEY_Y }
  ,{ 0x1d, KEY_Z,          KEY_Z }  // z and Z
  ,{ 0x1e, KEY_1,          KEY_1 }  // 1 and !
  ,{ 0x1f, KEY_2,          KEY_2 }  // 2 and @
  ,{ 0x20, KEY_3,          KEY_3 }  // 3 and #
  ,{ 0x21, KEY_4,          KEY_4 }  // 4 and $
  ,{ 0x22, KEY_5,          KEY_5 }  // 5 and %
  ,{ 0x23, KEY_6,          KEY_6 }  // 6 and ^
  ,{ 0x24, KEY_7,          KEY_7 }  // 7 and &
  ,{ 0x25, KEY_8,          KEY_8 }  // 8 and *
  ,{ 0x26, KEY_9,          KEY_9 }  // 9 and (
  ,{ 0x27, KEY_ZERO,       KEY_ZERO }         // 0 and )
  ,{ 0x28, KEY_RETURN,     KEY_RETURN }       // Return
  ,{ 0x29, KEY_RUN_STOP,   KEY_RUN_STOP }     // Escape
  ,{ 0x2a, KEY_DEL,        KEY_DEL }          // Delete (Backspace)
  ,{ 0x2b, KEY_CTRL,       KEY_CTRL }         // Tab
  ,{ 0x2c, KEY_SPACE,      KEY_SPACE }        // Spacebar
  ,{ 0x2d, KEY_PLUS,       KEY_PLUS }         // - and _
  ,{ 0x2e, KEY_MINUS,      KEY_MINUS }        // = and +
  ,{ 0x2f, KEY_AT,         KEY_AT }           // [ and {
  ,{ 0x30, KEY_STAR,       KEY_STAR }         // ] and }
  ,{ 0x31, KEY_EQUALS,     KEY_EQUALS }       // \ and |
  ,{ 0x32, IGNORE_KEYCODE, IGNORE_KEYCODE }   // Int' # and ~
  ,{ 0x33, KEY_COLON,      KEY_COLON }        // ; and :
  ,{ 0x34, KEY_SEMICOLON,  KEY_SEMICOLON }    // ‘ and “
  ,{ 0x35, KEY_ARR_LEFT,   KEY_ARR_LEFT }     // Grave Accent and Tilde
  ,{ 0x36, KEY_COMMA,      KEY_COMMA }        // , and <
  ,{ 0x37, KEY_DOT,        KEY_DOT }          // . and >
  ,{ 0x38, KEY_SLASH,      KEY_SLASH }        // / and ?
  ,{ 0x39, KEY_RUN_STOP,   KEY_RUN_STOP }     // Caps Lock
  ,{ 0x3a, KEY_F1,         KEY_F1 }           // F1
  ,{ 0x3b, KEY_F1 | MOD_SHIFT, KEY_F1 }       // F2
  ,{ 0x3c, KEY_F3,         KEY_F3 }           // F3
  ,{ 0x3d, KEY_F3 | MOD_SHIFT,  KEY_F3 }      // F4
  ,{ 0x3e, KEY_F5,         KEY_F5 }           // F5
  ,{ 0x3f, KEY_F5 | MOD_SHIFT, KEY_F5 }       // F6
  ,{ 0x40, KEY_F7,         KEY_F7 }           // F7
  ,{ 0x41, KEY_F7 | MOD_SHIFT, KEY_F7 }       // F8
  ,{ 0x42, IGNORE_KEYCODE, IGNORE_KEYCODE }   // F9
  ,{ 0x43, IGNORE_KEYCODE, IGNORE_KEYCODE }   // F10
  ,{ 0x44, C128_40_80_KEY, C128_40_80_KEY }   // F11
  ,{ 0x45, C128_CAPS_KEY,  C128_CAPS_KEY }    // F12
  ,{ 0x46, KEY_MT_RESET,   KEY_MT_RESET }     // PrintScreen
  ,{ 0x47, KEY_SHIFT_LOCK, KEY_SHIFT_LOCK }   // Scroll Lock
  ,{ 0x48, KEY_KEYMAP,     KEY_KEYMAP }       // Pause
  ,{ 0x49, KEY_POUND,      KEY_POUND }        // Insert
  ,{ 0x4a, KEY_HOME,       KEY_HOME }         // Home
  ,{ 0x4b, KEY_RESTORE,    KEY_RESTORE }      // PageUp
  ,{ 0x4c, KEY_ARR_UP,     KEY_ARR_UP }       // Delete(forward)
  ,{ 0x4d, KEY_RUN_STOP,   KEY_RUN_STOP }     // End
  ,{ 0x4e, IGNORE_KEYCODE, IGNORE_KEYCODE }   // PageDown
  ,{ 0x4f, KEY_HORZ_CSR,   KEY_HORZ_CSR }     // RightArrow
  ,{ 0x50, KEY_HORZ_CSR | MOD_SHIFT, KEY_HORZ_CSR }     // LeftArrow
  ,{ 0x51, KEY_VERT_CSR,   KEY_VERT_CSR }     // DownArrow
  ,{ 0x52, KEY_VERT_CSR | MOD_SHIFT, KEY_VERT_CSR } // UpArrow
  ,{ 0x53, KEY_JOY2_MODE,  KEY_JOY1_MODE }    // Keypad Num Lock and Clear
  ,{ 0x54, KEY_SLASH,      KEY_SLASH }        // Keypad /
  ,{ 0x55, KEY_STAR,       KEY_STAR }         // Keypad *
  ,{ 0x56, KEY_MINUS,      KEY_MINUS }        // Keypad -
  ,{ 0x57, KEY_PLUS,       KEY_PLUS }         // Keypad +
  ,{ 0x58, KEY_RETURN,     KEY_RETURN }       // Keypad ENTER
  ,{ 0x59, KEY_1,  KEY_1 }                    // Keypad 1 and End
  ,{ 0x5a, KEY_2,  KEY_2 }                    // Keypad 2 and Down Arrow
  ,{ 0x5b, KEY_3,  KEY_3 }                    // Keypad 3 and PageDn
  ,{ 0x5c, KEY_4,  KEY_4 }                    // Keypad 4 and Left Arrow
  ,{ 0x5d, KEY_5,  KEY_5 }                    // Keypad 5
  ,{ 0x5e, KEY_6,  KEY_6 }                    // Keypad 6 and Right Arrow
  ,{ 0x5f, KEY_7,  KEY_7 }                    // Keypad 7 and Home
  ,{ 0x60, KEY_8,  KEY_8 }                    // Keypad 8 and Up Arrow
  ,{ 0x61, KEY_9,  KEY_9 }                    // Keypad 9 and PageUp
  ,{ 0x62, KEY_ZERO,  KEY_ZERO }              // Keypad 0 and Insert
  ,{ 0x63, KEY_DOT, KEY_DOT }                 // Keypad . and Delete
  ,{ 0x64, KEY_EQUALS,     KEY_EQUALS }       // \ and | (non-US keyboard)
  ,{ 0x65, C128_KEY_LEFT,  C128_KEY_LEFT }    // Application (Menu)

  // symbolic mapping of extra keys that possibly exist on some keyboards
  ,{ 0x75, C128_KEY_HELP,  C128_KEY_HELP }    // Help

  ,{ 0xb6, KEY_8 | MOD_SHIFT, KEY_8 }         // Keypad (
  ,{ 0xb7, KEY_9 | MOD_SHIFT, KEY_9 }         // Keypad )

  ,{ 0xba, C128_KEY_TAB,   C128_KEY_TAB }     // Keypad Tab
  ,{ 0xbb, KEY_DEL,        KEY_DEL }          // Keypad Backspace
  ,{ 0xbc, KEY_A,          KEY_A }            // Keypad A
  ,{ 0xbd, KEY_B,          KEY_B }            // Keypad B
  ,{ 0xbe, KEY_C,          KEY_C }            // Keypad C
  ,{ 0xbf, KEY_D,          KEY_D }            // Keypad D
  ,{ 0xc0, KEY_E,          KEY_E }            // Keypad E
  ,{ 0xc1, KEY_F,          KEY_F }            // Keypad F

  ,{ 0xc3, KEY_ARR_UP,     KEY_ARR_UP }       // Keypad ^
  ,{ 0xc4, KEY_5 | MOD_SHIFT, KEY_5 }         // Keypad %
  ,{ 0xc5, KEY_COMMA | MOD_SHIFT, KEY_COMMA } // Keypad <
  ,{ 0xc6, KEY_DOT | MOD_SHIFT, KEY_DOT }     // Keypad >
  ,{ 0xc7, KEY_6 | MOD_SHIFT, KEY_6 }         // Keypad &

  ,{ 0xc9, KEY_POUND,      KEY_POUND }        // Keypad |

  ,{ 0xcb, KEY_COLON,      KEY_COLON }        // Keypad :
  ,{ 0xcc, KEY_3 | MOD_SHIFT, KEY_3 }         // Keypad #
  ,{ 0xcd, KEY_SPACE,      KEY_SPACE }        // Keypad Space
  ,{ 0xce, KEY_AT,         KEY_AT }           // Keypad @
  ,{ 0xcf, KEY_1 | MOD_SHIFT, KEY_1 }         // Keypad !

  ,{ 0xd7, KEY_PLUS,      KEY_MINUS }         // Keypad +/-

};

constexpr static uint16_t C64_pos_nkeys = sizeof(C64_pos_keys) / sizeof(C64_pos_keys[0]);

////////////////////////////////////////////////////////////////////////////////////////////////////////////////////////////////////

// C64 symbolic
// c64 symbolic (both controls are CTRL, both shifts unchanged, left/right WIN is CBM, left ALT is C128 ALT, altgr is RESTORE)
// C128 top row cursors assigned to shift+cursor arrows
// the only difference to c128 symbolic is in numpad mapping - it goes to plain digit keys and RETURN
constexpr static ModifierMap C64_sym_mods = {{KEY_CTRL, KEY_LSHIFT, C128_KEY_ALT, KEY_CBM, KEY_CTRL, KEY_RSHIFT, KEY_RESTORE, KEY_CBM}};
constexpr static C64Key C64_sym_keys[] = {
   { 0x00, IGNORE_KEYCODE, IGNORE_KEYCODE }  // Reserved
  ,{ 0x01, IGNORE_KEYCODE, IGNORE_KEYCODE }  // ErrorRollOver
  ,{ 0x02, IGNORE_KEYCODE, IGNORE_KEYCODE }  // POSTFail
  ,{ 0x03, IGNORE_KEYCODE, IGNORE_KEYCODE }  // ErrorUndefined
  ,{ 0x04, KEY_A,          KEY_A }  // a and A
  ,{ 0x05, KEY_B,          KEY_B }
  ,{ 0x06, KEY_C,          KEY_C }
  ,{ 0x07, KEY_D,          KEY_D }
  ,{ 0x08, KEY_E,          KEY_E }
  ,{ 0x09, KEY_F,          KEY_F }
  ,{ 0x0a, KEY_G,          KEY_G }
  ,{ 0x0b, KEY_H,          KEY_H }
  ,{ 0x0c, KEY_I,          KEY_I }
  ,{ 0x0d, KEY_J,          KEY_J }
  ,{ 0x0e, KEY_K,          KEY_K }
  ,{ 0x0f, KEY_L,          KEY_L }
  ,{ 0x10, KEY_M,          KEY_M }
  ,{ 0x11, KEY_N,          KEY_N }
  ,{ 0x12, KEY_O,          KEY_O }
  ,{ 0x13, KEY_P,          KEY_P }
  ,{ 0x14, KEY_Q,          KEY_Q }
  ,{ 0x15, KEY_R,          KEY_R }
  ,{ 0x16, KEY_S,          KEY_S }
  ,{ 0x17, KEY_T,          KEY_T }
  ,{ 0x18, KEY_U,          KEY_U }
  ,{ 0x19, KEY_V,          KEY_V }
  ,{ 0x1a, KEY_W,          KEY_W }
  ,{ 0x1b, KEY_X,          KEY_X }
  ,{ 0x1c, KEY_Y,          KEY_Y }
  ,{ 0x1d, KEY_Z,          KEY_Z }  // z and Z
  ,{ 0x1e, KEY_1,          KEY_1 }  // 1 and !
  ,{ 0x1f, KEY_2,          KEY_AT | MOD_SHIFT } // 2 and @
  ,{ 0x20, KEY_3,          KEY_3 }  // 3 and #
  ,{ 0x21, KEY_4,          KEY_4 }  // 4 and $
  ,{ 0x22, KEY_5,          KEY_5 }  // 5 and %
  ,{ 0x23, KEY_6,          KEY_ARR_UP | MOD_SHIFT } // 6 and ^
  ,{ 0x24, KEY_7,          KEY_6 }  // 7 and &
  ,{ 0x25, KEY_8,          KEY_STAR | MOD_SHIFT } // 8 and *
  ,{ 0x26, KEY_9,          KEY_8 }  // 9 and (
  ,{ 0x27, KEY_ZERO,       KEY_9 }  // 0 and )
  ,{ 0x28, KEY_RETURN,     C128_KEY_LINEFEED | MOD_SHIFT } // Return
  ,{ 0x29, C128_KEY_ESC,   C128_KEY_ESC }     // Escape
  ,{ 0x2a, KEY_DEL,        KEY_DEL }          // Delete (Backspace)
  ,{ 0x2b, C128_KEY_TAB,   C128_KEY_TAB }     // Tab
  ,{ 0x2c, KEY_SPACE,      KEY_SPACE }        // Spacebar
  ,{ 0x2d, KEY_MINUS,      KEY_MINUS }        // - and _
  ,{ 0x2e, KEY_EQUALS,     KEY_PLUS | MOD_SHIFT } // = and +
  ,{ 0x2f, KEY_COLON | MOD_SHIFT, KEY_COLON } // [ and {
  ,{ 0x30, KEY_SEMICOLON | MOD_SHIFT, KEY_SEMICOLON } // ] and }
  ,{ 0x31, KEY_POUND,      KEY_POUND }        // \ and |
  ,{ 0x32, IGNORE_KEYCODE, IGNORE_KEYCODE }   // Int' # and ~
  ,{ 0x33, KEY_SEMICOLON,  KEY_COLON | MOD_SHIFT } // ; and :
  ,{ 0x34, KEY_7 | MOD_SHIFT,  KEY_2 }        // ‘ and “
  ,{ 0x35, KEY_ARR_LEFT,   KEY_ARR_LEFT }     // Grave Accent and Tilde
  ,{ 0x36, KEY_COMMA,      KEY_COMMA }        // , and <
  ,{ 0x37, KEY_DOT,        KEY_DOT }          // . and >
  ,{ 0x38, KEY_SLASH,      KEY_SLASH }        // / and ?
  ,{ 0x39, KEY_RUN_STOP,   KEY_RUN_STOP }     // Caps Lock
  ,{ 0x3a, KEY_F1,         KEY_F1 }           // F1
  ,{ 0x3b, KEY_F1 | MOD_SHIFT, KEY_F1 }       // F2
  ,{ 0x3c, KEY_F3,         KEY_F3 }           // F3
  ,{ 0x3d, KEY_F3 | MOD_SHIFT,  KEY_F3 }      // F4
  ,{ 0x3e, KEY_F5,         KEY_F5 }           // F5
  ,{ 0x3f, KEY_F5 | MOD_SHIFT, KEY_F5 }       // F6
  ,{ 0x40, KEY_F7,         KEY_F7 }           // F7
  ,{ 0x41, KEY_F7 | MOD_SHIFT, KEY_F7 }       // F8
  ,{ 0x42, C128_KEY_HELP,  C128_KEY_HELP }    // F9
  ,{ 0x43, C128_KEY_NOSCROLL, C128_KEY_NOSCROLL } // F10
  ,{ 0x44, C128_40_80_KEY, C128_40_80_KEY }   // F11
  ,{ 0x45, C128_CAPS_KEY,  C128_CAPS_KEY }    // F12
  ,{ 0x46, KEY_MT_RESET,   KEY_MT_RESET }     // PrintScreen
  ,{ 0x47, KEY_SHIFT_LOCK, KEY_SHIFT_LOCK }   // Scroll Lock
  ,{ 0x48, KEY_KEYMAP,     KEY_KEYMAP }       // Pause
  ,{ 0x49, KEY_DEL | MOD_SHIFT, KEY_DEL }     // Insert
  ,{ 0x4a, KEY_HOME,       KEY_HOME }         // Home
  ,{ 0x4b, KEY_RESTORE,    KEY_RESTORE }      // PageUp
  ,{ 0x4c, KEY_DEL,        KEY_DEL }          // Delete(forward)
  ,{ 0x4d, KEY_RUN_STOP,   KEY_RUN_STOP }     // End
  ,{ 0x4e, IGNORE_KEYCODE, IGNORE_KEYCODE }   // PageDown
  ,{ 0x4f, KEY_HORZ_CSR,   C128_KEY_RIGHT | MOD_SHIFT } // RightArrow
  ,{ 0x50, KEY_HORZ_CSR | MOD_SHIFT, C128_KEY_LEFT | MOD_SHIFT } // LeftArrow
  ,{ 0x51, KEY_VERT_CSR,   C128_KEY_DOWN | MOD_SHIFT } // DownArrow
  ,{ 0x52, KEY_VERT_CSR | MOD_SHIFT, C128_KEY_UP | MOD_SHIFT } // UpArrow
  ,{ 0x53, KEY_JOY2_MODE,  KEY_JOY1_MODE }    // Keypad Num Lock and Clear
  ,{ 0x54, KEY_SLASH,      KEY_SLASH }        // Keypad /
  ,{ 0x55, KEY_STAR,       KEY_STAR }         // Keypad *
  ,{ 0x56, KEY_MINUS,      KEY_MINUS }        // Keypad -
  ,{ 0x57, KEY_PLUS,       KEY_PLUS }         // Keypad +
  ,{ 0x58, KEY_RETURN,     KEY_RETURN }       // Keypad ENTER
  ,{ 0x59, KEY_1,  KEY_1 }                    // Keypad 1 and End
  ,{ 0x5a, KEY_2,  KEY_2 }                    // Keypad 2 and Down Arrow
  ,{ 0x5b, KEY_3,  KEY_3 }                    // Keypad 3 and PageDn
  ,{ 0x5c, KEY_4,  KEY_4 }                    // Keypad 4 and Left Arrow
  ,{ 0x5d, KEY_5,  KEY_5 }                    // Keypad 5
  ,{ 0x5e, KEY_6,  KEY_6 }                    // Keypad 6 and Right Arrow
  ,{ 0x5f, KEY_7,  KEY_7 }                    // Keypad 7 and Home
  ,{ 0x60, KEY_8,  KEY_8 }                    // Keypad 8 and Up Arrow
  ,{ 0x61, KEY_9,  KEY_9 }                    // Keypad 9 and PageUp
  ,{ 0x62, KEY_ZERO,  KEY_ZERO }              // Keypad 0 and Insert
  ,{ 0x63, KEY_DOT, KEY_DOT }                 // Keypad . and Delete
  ,{ 0x64, KEY_POUND,      KEY_POUND }        // \ and | (non-US keyboard)
  ,{ 0x65, C128_KEY_LEFT,  C128_KEY_LEFT }    // Application (Menu)

  // symbolic mapping of extra keys that possibly exist on some keyboards
  ,{ 0x75, C128_KEY_HELP,  C128_KEY_HELP }    // Help

  ,{ 0xb6, KEY_8 | MOD_SHIFT, KEY_8 }         // Keypad (
  ,{ 0xb7, KEY_9 | MOD_SHIFT, KEY_9 }         // Keypad )

  ,{ 0xba, C128_KEY_TAB,   C128_KEY_TAB }     // Keypad Tab
  ,{ 0xbb, KEY_DEL,        KEY_DEL }          // Keypad Backspace
  ,{ 0xbc, KEY_A,          KEY_A }            // Keypad A
  ,{ 0xbd, KEY_B,          KEY_B }            // Keypad B
  ,{ 0xbe, KEY_C,          KEY_C }            // Keypad C
  ,{ 0xbf, KEY_D,          KEY_D }            // Keypad D
  ,{ 0xc0, KEY_E,          KEY_E }            // Keypad E
  ,{ 0xc1, KEY_F,          KEY_F }            // Keypad F

  ,{ 0xc3, KEY_ARR_UP,     KEY_ARR_UP }       // Keypad ^
  ,{ 0xc4, KEY_5 | MOD_SHIFT, KEY_5 }         // Keypad %
  ,{ 0xc5, KEY_COMMA | MOD_SHIFT, KEY_COMMA } // Keypad <
  ,{ 0xc6, KEY_DOT | MOD_SHIFT, KEY_DOT }     // Keypad >
  ,{ 0xc7, KEY_6 | MOD_SHIFT, KEY_6 }         // Keypad &

  ,{ 0xc9, KEY_POUND,      KEY_POUND }        // Keypad |

  ,{ 0xcb, KEY_COLON,      KEY_COLON }        // Keypad :
  ,{ 0xcc, KEY_3 | MOD_SHIFT, KEY_3 }         // Keypad #
  ,{ 0xcd, KEY_SPACE,      KEY_SPACE }        // Keypad Space
  ,{ 0xce, KEY_AT,         KEY_AT }           // Keypad @
  ,{ 0xcf, KEY_1 | MOD_SHIFT, KEY_1 }         // Keypad !

  ,{ 0xd7, KEY_PLUS,      KEY_MINUS }         // Keypad +/-

};

constexpr static uint16_t C64_sym_nkeys = sizeof(C64_sym_keys) / sizeof(C64_sym_keys[0]);

////////////////////////////////////////////////////////////////////////////////////////////////////////////////////////////////////


////////////////////////////////////////////////////////////////////////////////////////////////////////////////////////////////////
////////////////////////////////////////////////////////////////////////////////////////////////////////////////////////////////////

constexpr static C64KeyMap keymaps[] = {
   C64KeyMap("C128 positional", C128_pos_keys, C128_pos_nkeys, C128_pos_mods )
  ,C64KeyMap("C128 symbolic", C128_sym_keys, C128_sym_nkeys, C128_sym_mods )
  ,C64KeyMap("C64 positional", C64_pos_keys, C64_pos_nkeys, C64_pos_mods )
  ,C64KeyMap("C64 symbolic", C64_sym_keys, C64_sym_nkeys, C64_sym_mods )
};

constexpr static uint8_t nkeymaps = sizeof(keymaps) / sizeof(keymaps[0]);

// USB modifier usages 0xe0..0xe7 are translated through each map's mods array.
