ytmytm/C128-keyboard/SEEED/C128_keyboard/firmware_version.h

#ifndef C128_FIRMWARE_VERSION_H
#define C128_FIRMWARE_VERSION_H

// Release date (YYYY-MM-DD). Update when preparing a new firmware release.
// GitHub Release tag: vYYYY-MM-DD, using this exact date (see README release checklist).
constexpr char firmwareVersion[] = "2026-10-30";

#endif
