ytmytm/C128-keyboard/(commit log)

2023-12-29 archive library to be unpacked in Arduino libraries folder
2023-12-29 documentation and support files
    [OPL_List_2019-02-14.xlsx]
2023-12-29 KiCad project and plots
    [kicad-c128keyb-B_Cu.gbl, kicad-c128keyb-B_Mask.gbs, kicad-c128keyb-B_Silkscreen.gbo, kicad-c128keyb-Edge_Cuts.gm1, kicad-c128keyb-F_Cu.gtl, kicad-c128keyb-F_Mask.gts, kicad-c128keyb-F_Silkscreen.gto, kicad-c128keyb-NPTH-drl_map.gbr]
2023-12-29 clean source code import
    [KEYBIN_calc_c128.xlsx]
2024-11-02 register/unregister original keycodes to correctly identify released keys
    [C128_keyboard.ino, C128keyboard.c.ino, C128keyboard.h]
2026-10-27 Use one constexpr table for both joystick ports
    Replace duplicated joystick switch statements with a fixed-size std::array of USB usage and port mappings. Preserve right Ctrl FIRE, keypad mappings and fallback to the active keyboard map.
2026-10-27 Exclude RESTORE actions from shared matrix switch tracking
2026-10-27 Release keyboard outputs and parser state on USB disconnect
    Notify report parsers when an active HID boot device is released, including devices behind a hub. Reset keyboard report history and invoke the application disconnect callback to release matrix switches, FIRE routing, RESTORE and Shift Lock.
    Exercise the real release callback path in host tests, including reconnecting with the same keys held, repeated release and interfaces without parsers.
2026-10-30 Ship the matching USB library and reject outdated event APIs
    Refresh the Arduino-installable ZIP with the modifier and disconnect fixes. Require an event API marker so the updated sketch fails clearly when an older installed library is selected.
    Add a reproducible library packager and check archive/source consistency in host tests. Cover public modifier usages and distinguish modifier masks, HID usages and ASCII space. Document installing the matching library on the build computer.
2026-10-30 Complete README setup instructions and correct mapping descriptions
    Document Windows library replacement, board and library dependencies, CLI builds, optional OLED behavior, keyboard compatibility and host tests. Correct the C64 positional function row, add missing controls and clarify joystick selection and LED behavior.
    Point readers to the current KiCad files instead of the legacy Pro Micro schematic and correct the DB25 connector name. List U2 as 74HC/HCT/LS595 as requested. Verify local documentation links and keymap descriptions against source.
2026-10-30 Build and verify XIAO SAMD21 UF2 firmware in GitHub Actions
    Run host regressions and a pinned Arduino CLI build with the USB library from the checkout. Convert with the pinned official Microsoft UF2 tool and verify application vectors, target addresses, SAMD21 family and complete payload integrity.
    Upload versioned UF2, BIN, ELF, metadata and SHA-256 files as build artifacts. Attach verified assets to manually published releases only when their tag matches the firmware date. Document the build and release process.
